LazarevMike/Mini_Omni_Bot/docs/images/photos/IMG_6936.jpg

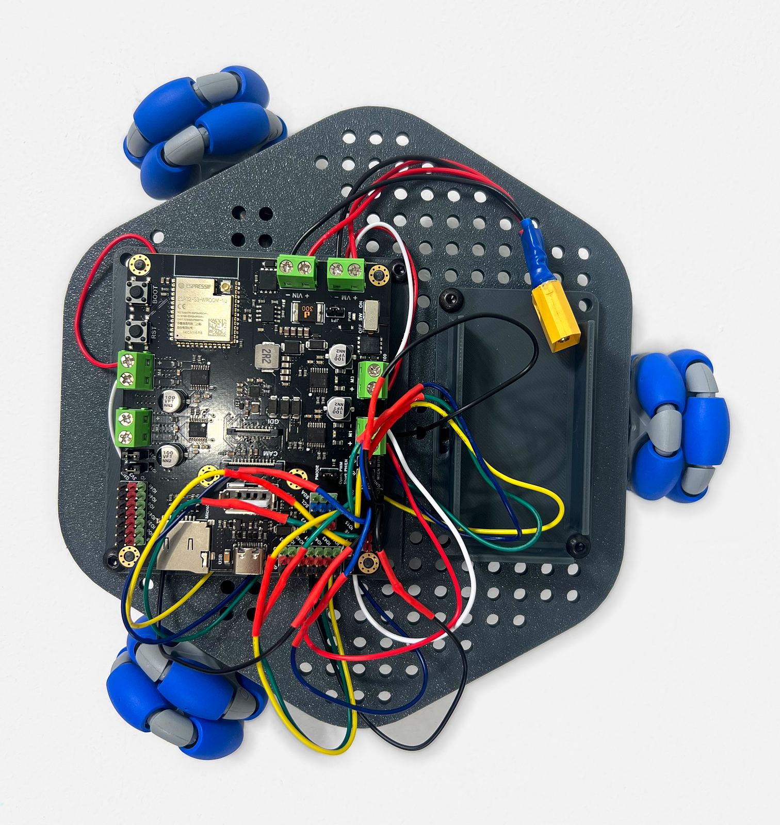
docs/images/photos/IMG_6936.jpg
