LazarevMike/Mini_Omni_Bot/docs/images/photos/IMG_6937.jpg

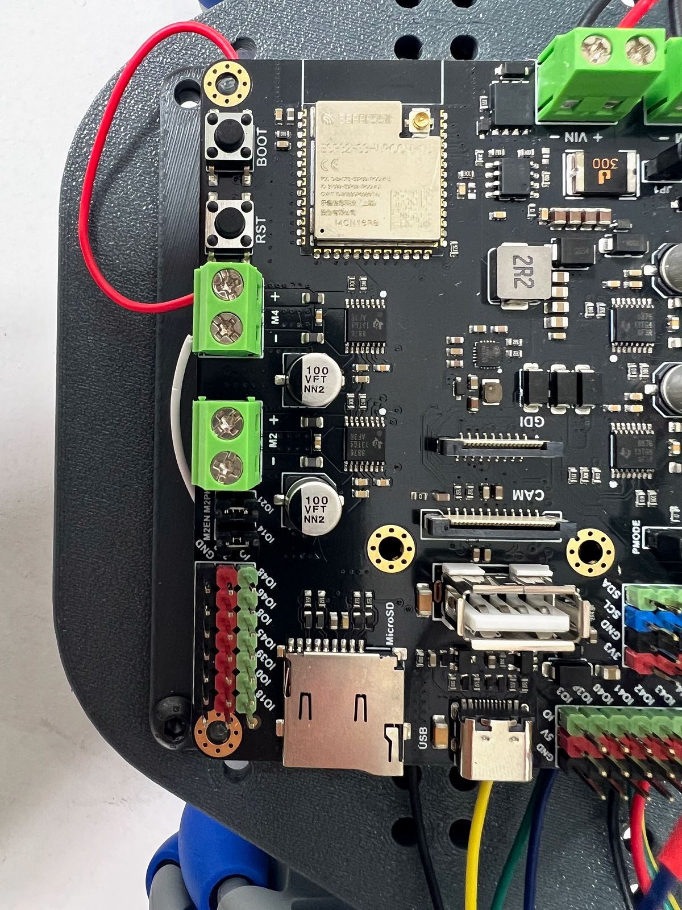
docs/images/photos/IMG_6937.jpg
