LazarevMike/Mini_Omni_Bot/docs/images/photos/IMG_6938.jpg

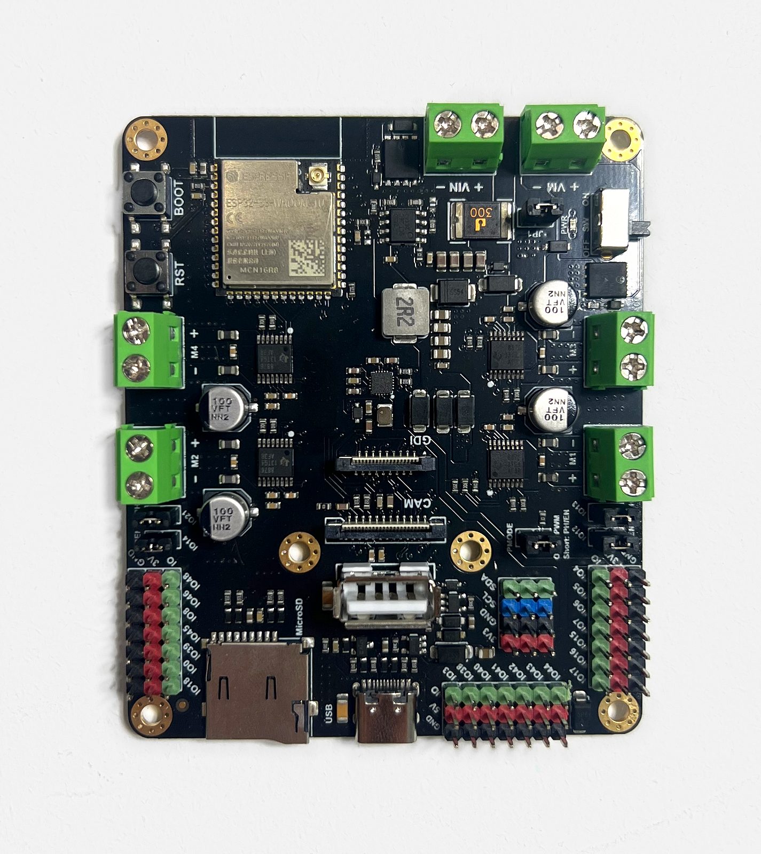
docs/images/photos/IMG_6938.jpg
