LazarevMike/Mini_Omni_Bot/docs/images/photos/IMG_6941.jpg

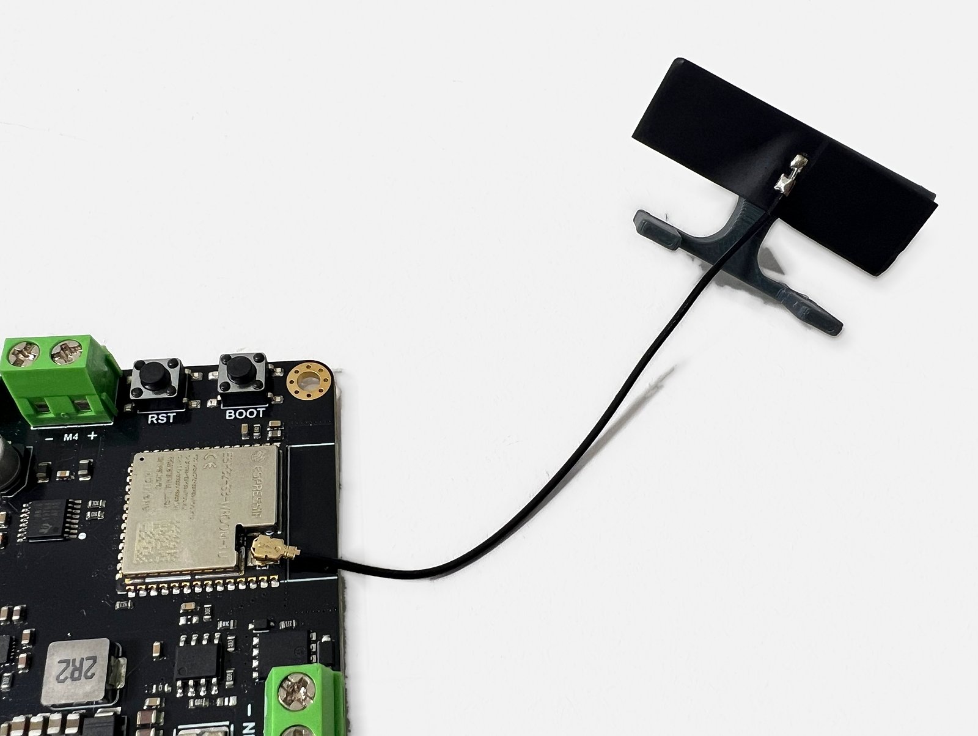
docs/images/photos/IMG_6941.jpg
