LazarevMike/Mini_Omni_Bot/docs/images/photos/IMG_6943.jpg

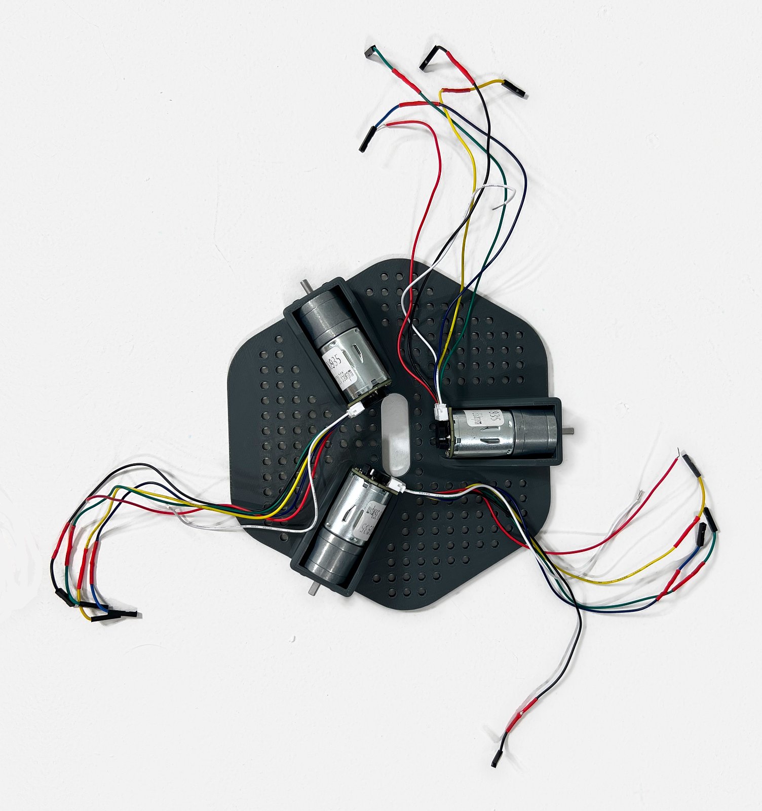
docs/images/photos/IMG_6943.jpg
