LazarevMike/Mini_Omni_Bot/docs/images/photos/IMG_6944.jpg

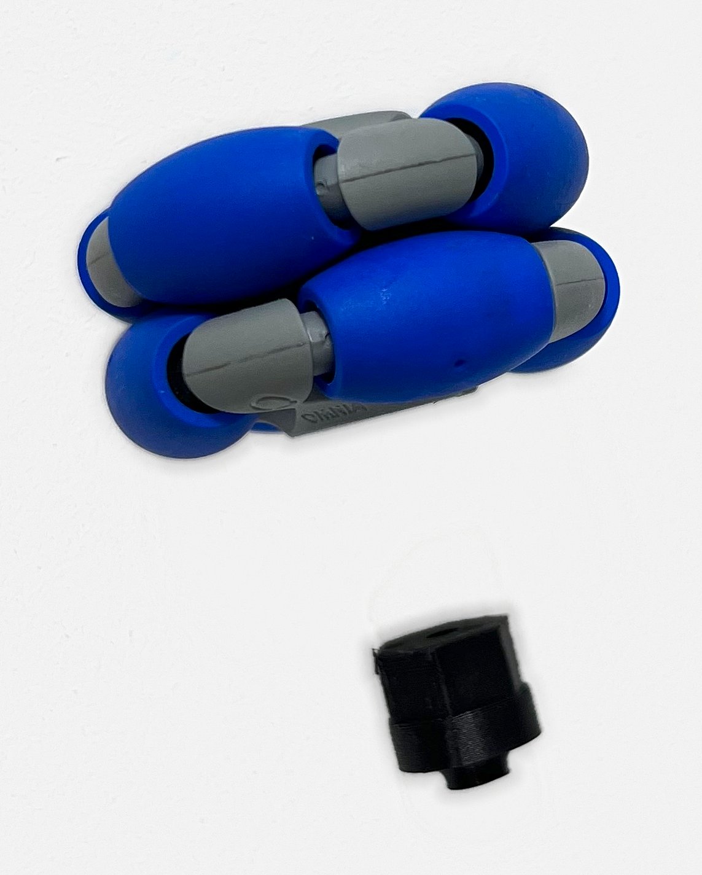
docs/images/photos/IMG_6944.jpg
