LazarevMike/Mini_Omni_Bot/docs/images/photos/IMG_6945.jpg

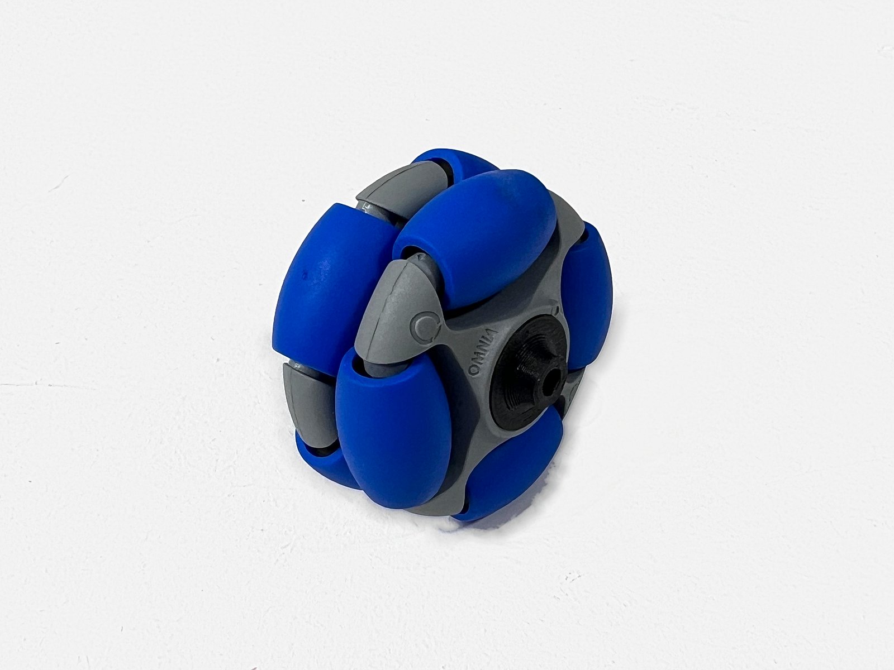
docs/images/photos/IMG_6945.jpg
