LazarevMike/Mini_Omni_Bot/docs/images/photos/IMG_6946.jpg

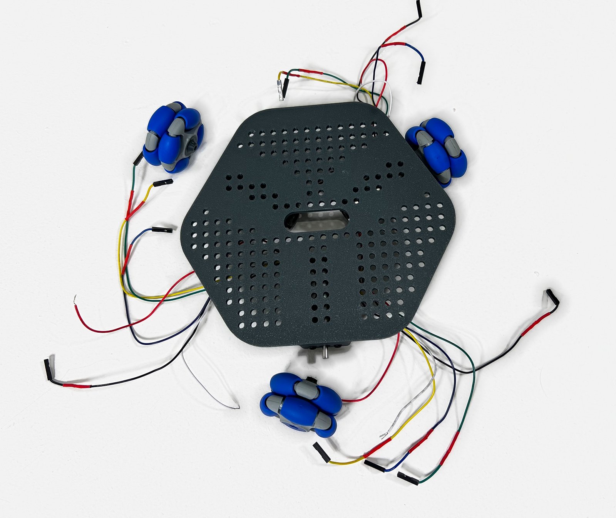
docs/images/photos/IMG_6946.jpg
