LazarevMike/Mini_Omni_Bot/docs/images/photos/IMG_6948.jpg

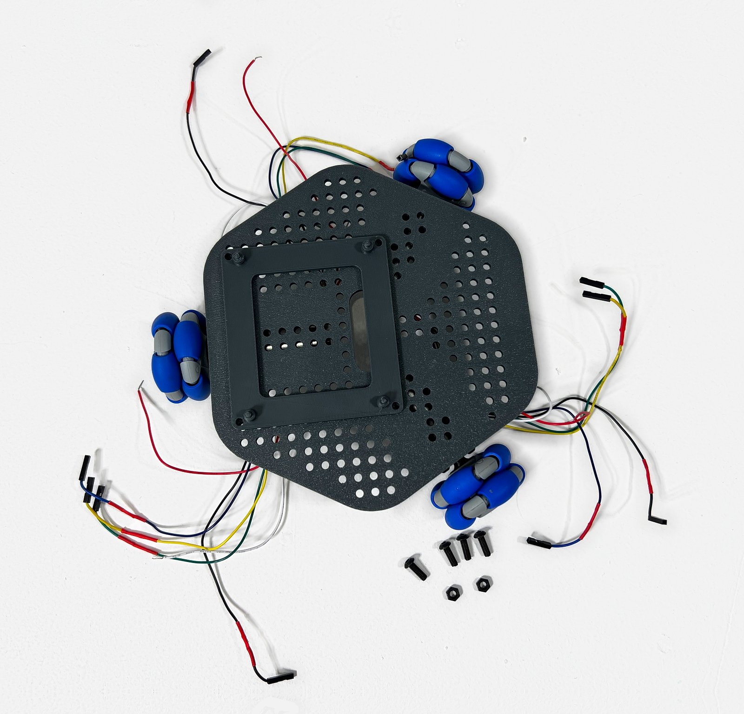
docs/images/photos/IMG_6948.jpg
