LazarevMike/Mini_Omni_Bot/docs/images/photos/IMG_6949.jpg

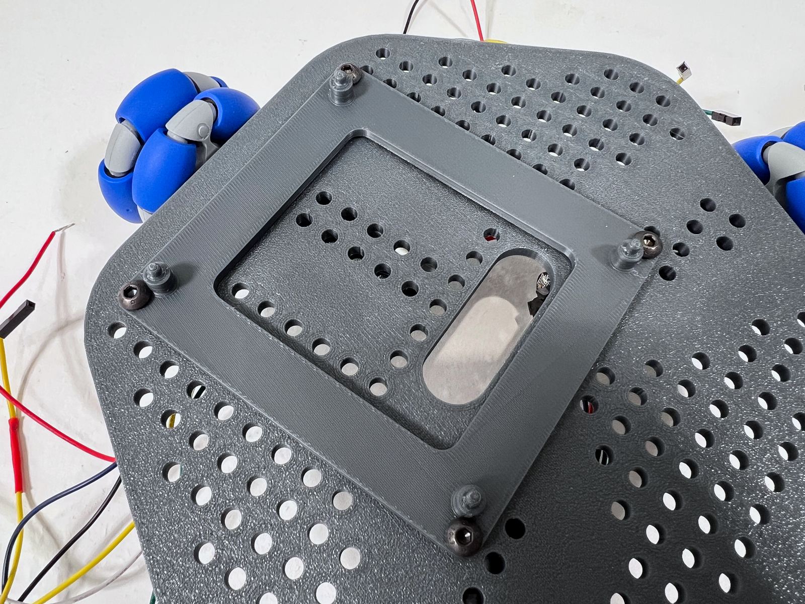
docs/images/photos/IMG_6949.jpg
