LazarevMike/Mini_Omni_Bot/docs/images/photos/IMG_6950.jpg

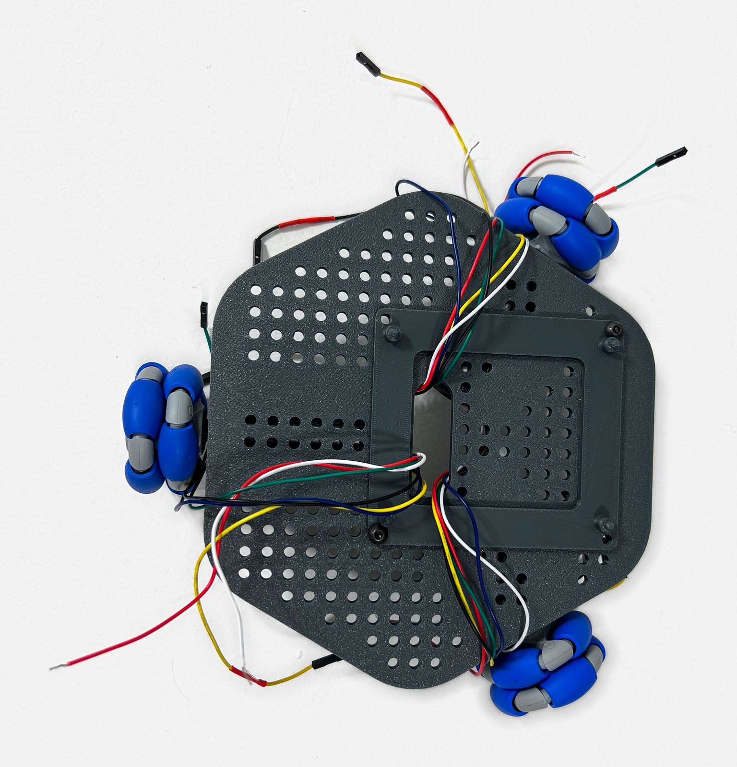
docs/images/photos/IMG_6950.jpg
