LazarevMike/Mini_Omni_Bot/docs/images/photos/IMG_6952.jpg

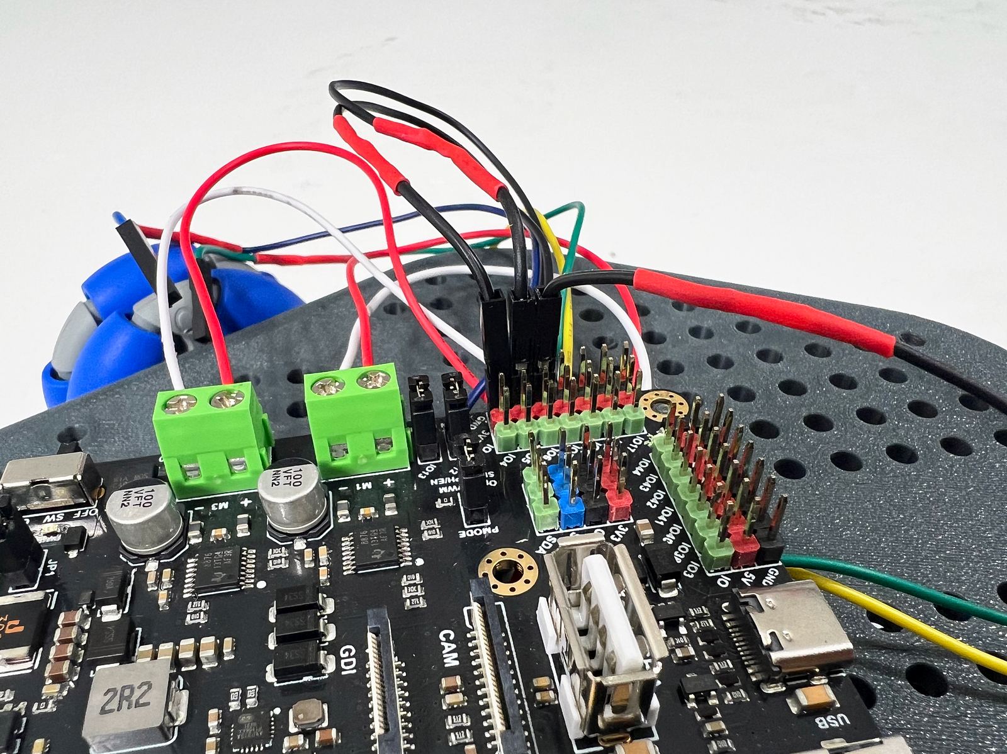
docs/images/photos/IMG_6952.jpg
