LazarevMike/Mini_Omni_Bot/docs/images/photos/IMG_6953.jpg

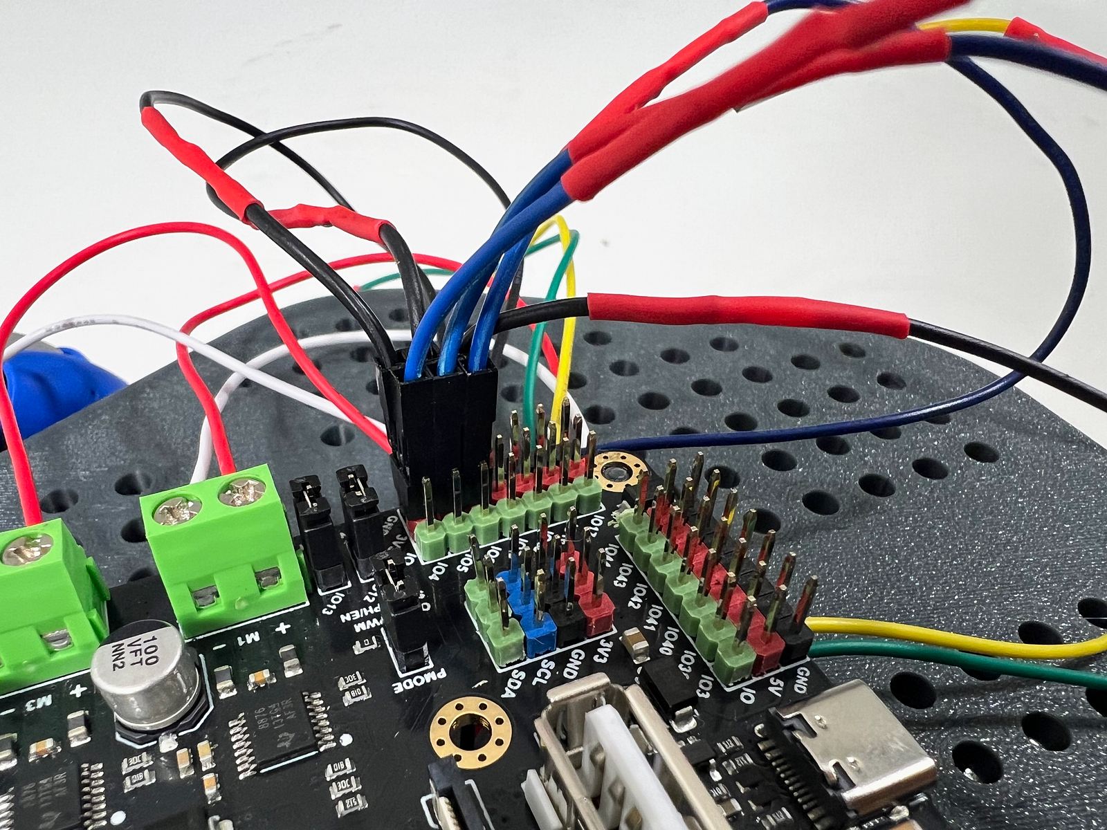
docs/images/photos/IMG_6953.jpg
