LazarevMike/Mini_Omni_Bot/docs/images/photos/IMG_6955.jpg

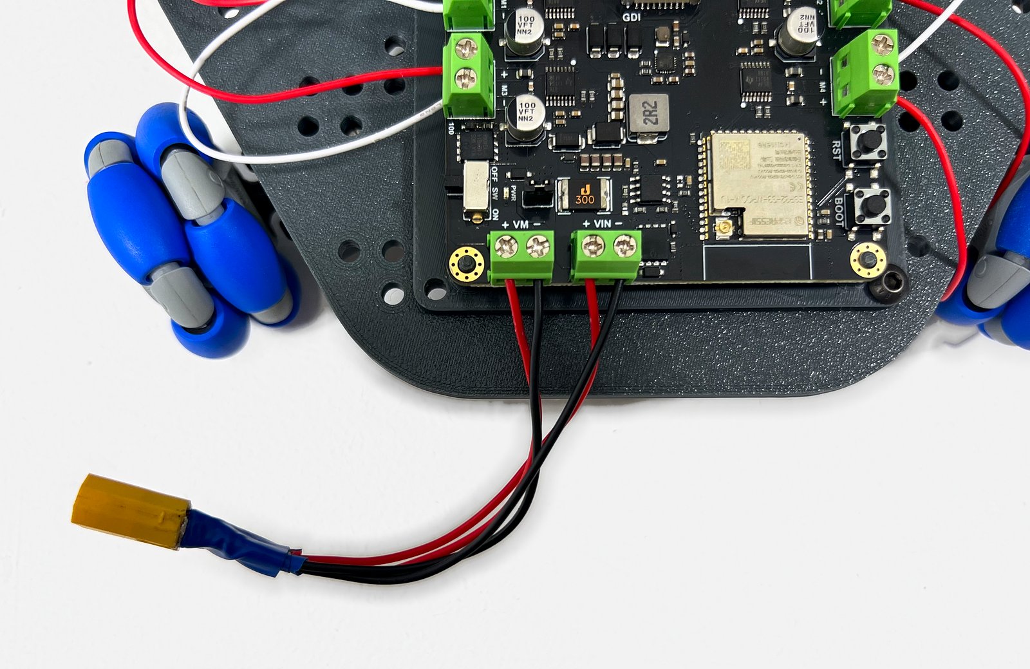
docs/images/photos/IMG_6955.jpg
