LazarevMike/Mini_Omni_Bot/docs/images/photos/IMG_6958.jpg

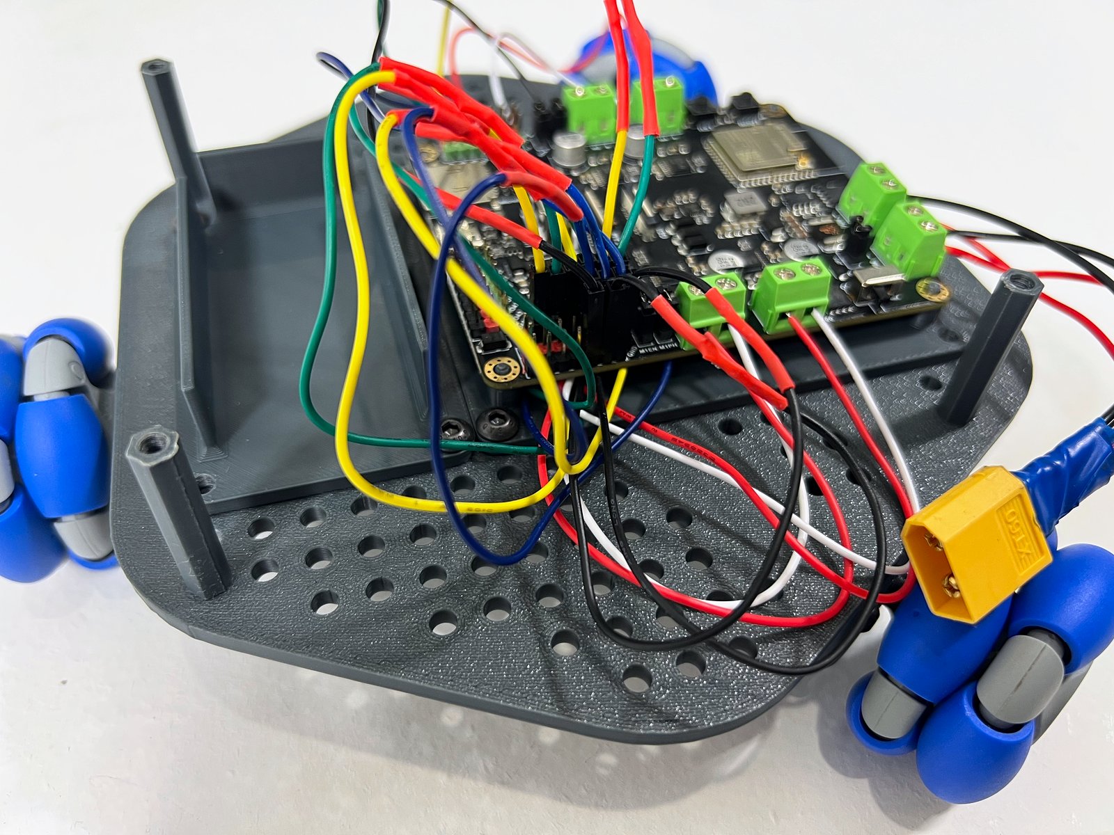
docs/images/photos/IMG_6958.jpg
