LazarevMike/Mini_Omni_Bot/docs/images/photos/IMG_6959.jpg

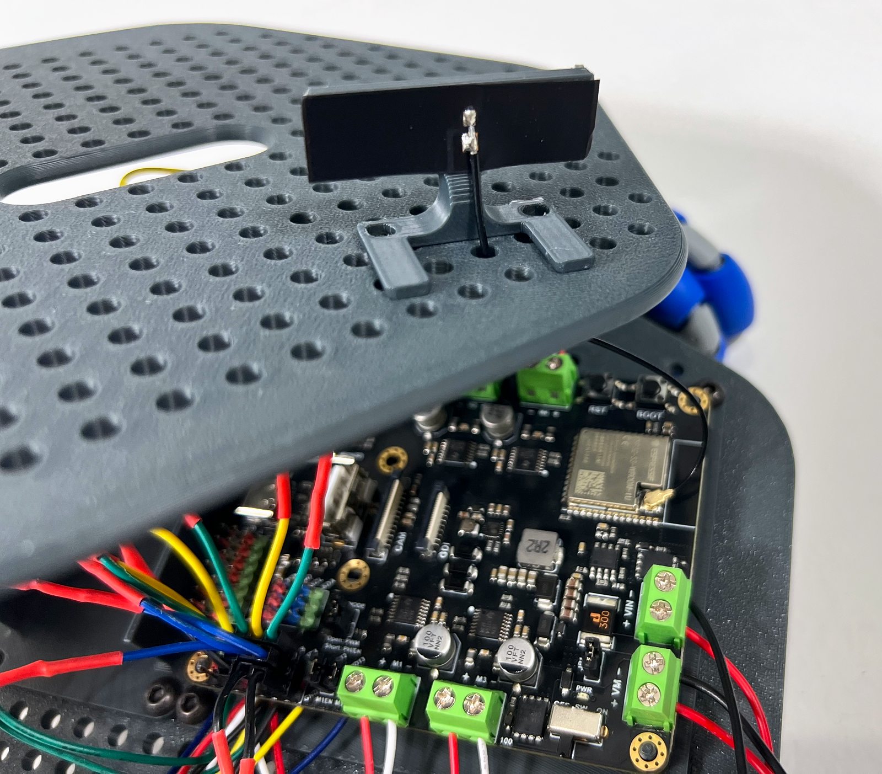
docs/images/photos/IMG_6959.jpg
