LazarevMike/Mini_Omni_Bot/docs/images/photos/IMG_6960.jpg

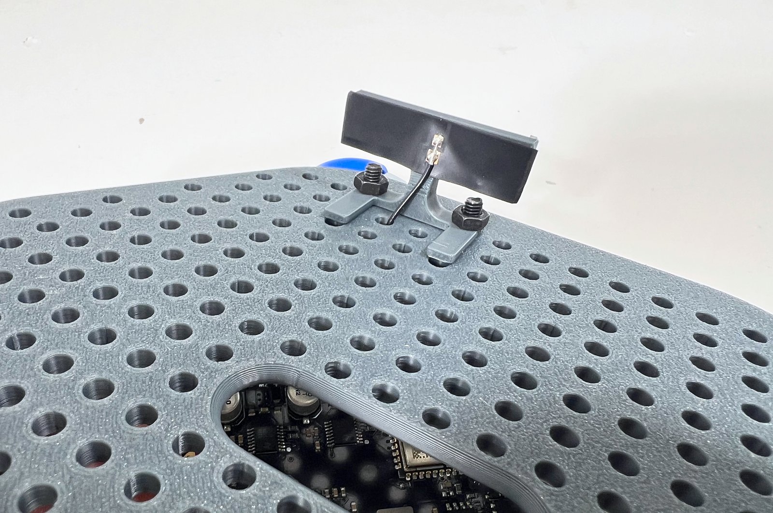
docs/images/photos/IMG_6960.jpg
