LazarevMike/Mini_Omni_Bot/docs/images/photos/IMG_6962.jpg

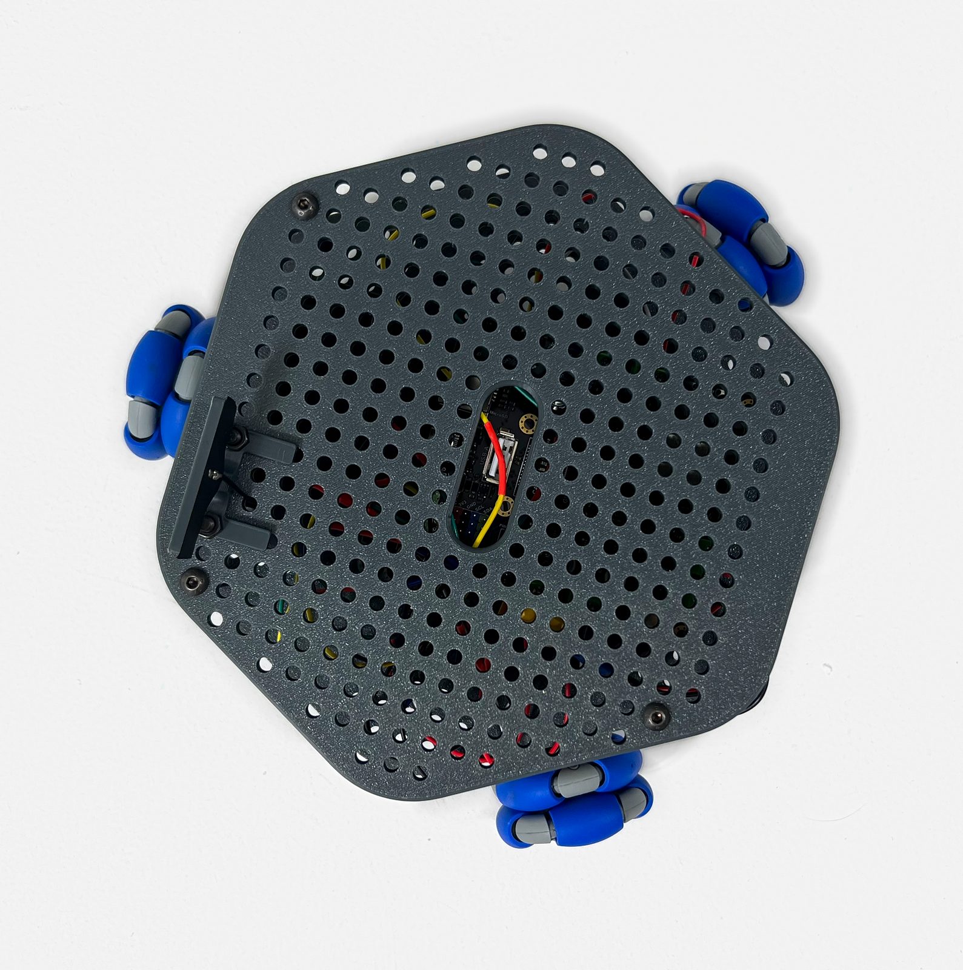
docs/images/photos/IMG_6962.jpg
