LazarevMike/Mini_Omni_Bot/docs/images/photos/IMG_6963.jpg

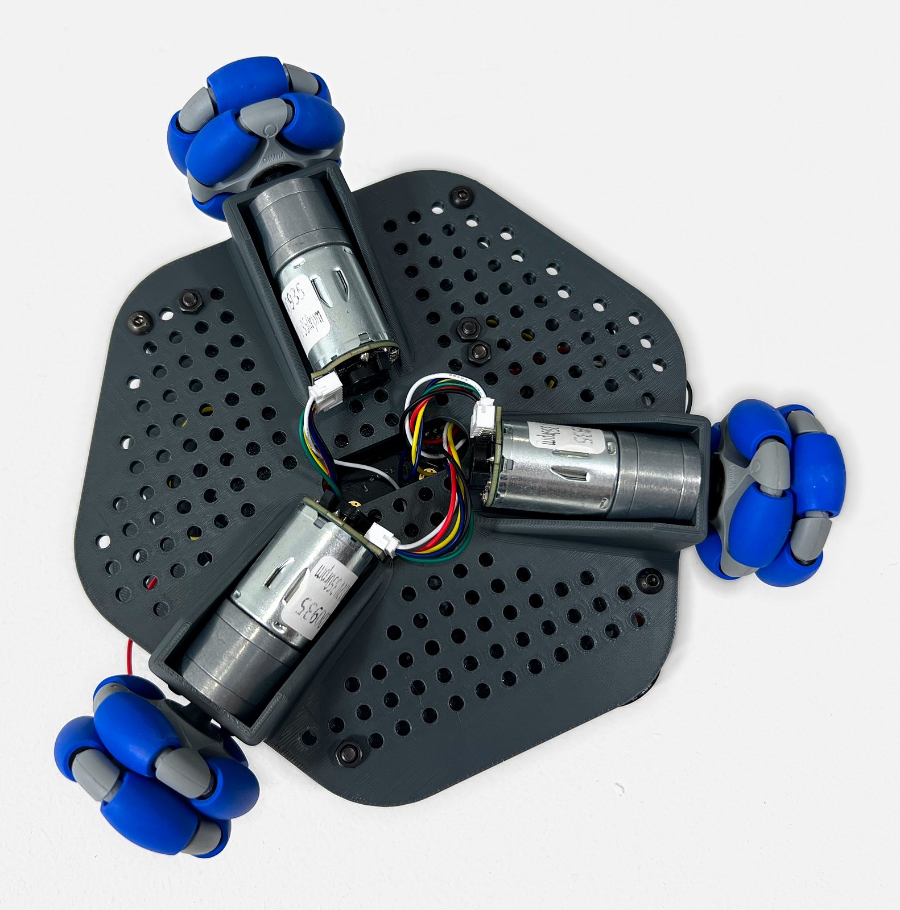
docs/images/photos/IMG_6963.jpg
