LazarevMike/Mini_Omni_Bot/(commit log)

2026-11-03 Link Omni Wheels by Omnia to the Omnia Wheel shop
    Add the wheel range picture under the README introduction, linked to the
    shop, and give the 50 mm wheel page as the source in the parts lists.
2026-11-03 Link every mention of where to buy the wheels to the 50 mm shop page
